MaruthiV/golem/web/preview.png

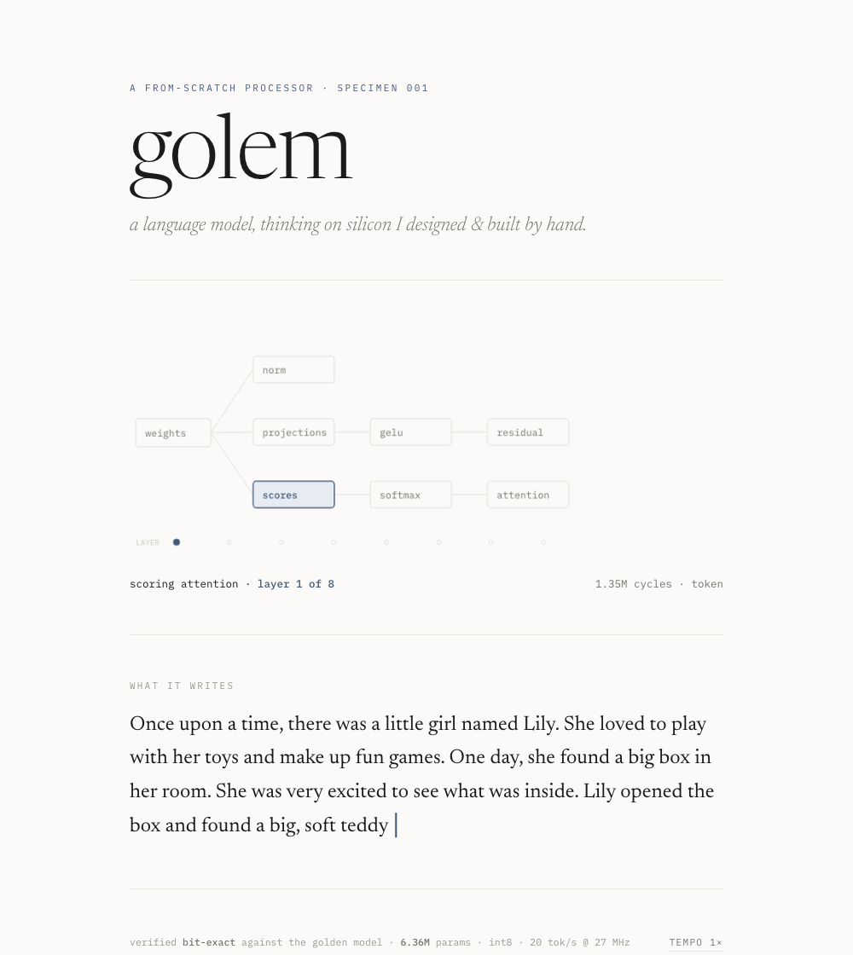
web/preview.png
