MaruthiV/golem/rtl/golem_board_top.sv

// golem_board_top — the actual FPGA top for the Tang Nano 20K. Boot flow:
//   LOAD: host streams the weight image over UART -> weight_loader writes it into SDRAM.
//   RUN:  control FSM drives golem; tokens stream out UART; host maps ids->text.
// NOTE: SDRAM modeled/wired 32-bit (matches the verified sim). Confirm the real chip's
// data width/timing from the datasheet during bring-up and adapt the data phase if 16-bit.
module golem_board_top #(
    // Internal clock. USE_PLL=0 runs straight off the 27 MHz oscillator; USE_PLL=1 brings up the
    // rPLL and everything (logic AND SDRAM) runs at CLK_MHZ. Raising this is the whole of T68:
    // golem is only 6% memory-stalled, so tok/s is now linear in the clock. Divider values must
    // satisfy CLK_MHZ = 27*(PLL_FBDIV+1)/(PLL_IDIV+1) with 400 <= CLK_MHZ*PLL_ODIV <= 1200.
    parameter int CLK_MHZ = 27,
    parameter int USE_PLL = 0,
    parameter int PLL_IDIV = 8, parameter int PLL_FBDIV = 21, parameter int PLL_ODIV = 8,
    parameter int PLL_PHASE = 10,          // SDRAM clock phase, 16ths of a period; swept on the board (T70/G7)
    parameter int DEMO_SLOW = 0,           // hold each pipeline stage on the LEDs long enough to film
    parameter int BAUD = 921600,           // 6.5 MB of weights is 9.4 min at 115200, 70 s here
    parameter int CLKS_PER_BIT = 0,        // 0 = derive from CLK_MHZ and BAUD
    parameter [11:0] START_TOK = 12'd0,
    parameter [7:0]  MAX_TOKENS = 8'd120,
    parameter [21:0] N_WORDS = 22'd1624264
) (
    input  logic        clk27,
    input  logic        rst_n,
    input  logic        uart_rx_pin,
    output logic        uart_tx_pin,
    output logic [5:0]  led,

    // The GW2AR-18's SDRAM is inside the package (SiP). nextpnr-himbaechel wires it up via
    // these EXACT dedicated port names — there are no IO_LOC constraints for SDRAM, which is
    // why nand2mario's working .cst has none. Naming them anything else (we had sdram_cs_n
    // etc.) makes nextpnr treat them as ordinary user I/O and fail with "Unconstrained IO".
    // addr is 11 bits here (2048 rows), not the controller's generic 13.
    output logic        O_sdram_clk,
    output logic        O_sdram_cke,
    output logic        O_sdram_cs_n, O_sdram_ras_n, O_sdram_cas_n, O_sdram_wen_n,
    output logic [3:0]  O_sdram_dqm,
    output logic [10:0] O_sdram_addr,
    output logic [1:0]  O_sdram_ba,
    inout  wire  [31:0] IO_sdram_dq
);
  localparam int CPB = (CLKS_PER_BIT > 0) ? CLKS_PER_BIT : (CLK_MHZ * 1000000) / BAUD;

  wire clk, sdram_clk;
  generate if (USE_PLL) begin : g_pll
    pll #(.IDIV(PLL_IDIV), .FBDIV(PLL_FBDIV), .ODIV(PLL_ODIV), .PHASE(PLL_PHASE))
      u_pll(.clkin(clk27), .clkout(clk), .clkoutp(sdram_clk), .lock());
  end else begin : g_nopll
    assign clk = clk27;
    assign sdram_clk = clk27;
  end endgenerate

  logic [1:0] rsync;
  always_ff @(posedge clk) rsync <= {rsync[0], ~rst_n};
  wire rst = rsync[1];

  // ---- UART rx -> weight loader ----
  // bytes are ignored until the SDRAM finishes its 200 us power-up: otherwise they become words
  // the controller cannot accept yet, the loader drops them while it waits, and the image
  // desyncs. Gating valid costs one LUT; gating reset would sit on a high-fanout net.
  logic sdram_ready;
  logic [7:0] rx_data; logic rx_valid_raw;
  wire rx_valid = rx_valid_raw & sdram_ready;
  uart_rx #(.CLKS_PER_BIT(CPB)) u_rx(.clk(clk), .rst(rst), .rx(uart_rx_pin),
                .data(rx_data), .valid(rx_valid_raw));
  logic ld_valid, ld_wr; logic [21:0] ld_addr; logic [31:0] ld_wdata; logic ld_ready, load_done;
  weight_loader #(.N_WORDS(N_WORDS)) u_ld(.clk(clk), .rst(rst),
                .rx_data(rx_data), .rx_valid(rx_valid),
                .cmd_valid(ld_valid), .cmd_wr(ld_wr), .cmd_addr(ld_addr), .cmd_wdata(ld_wdata),
                .cmd_ready(ld_ready), .done(load_done));
  wire loading = !load_done;

  // ---- golem + arbiter (RUN) ----
  wire fsm_rst = rst | loading;   // hold generation until weights are loaded
  logic g_start, g_busy, g_tvalid; logic [11:0] g_token, g_tout; logic [7:0] g_pos;
  logic [4:0] g_st;
  logic mrd_req, mrd_valid; logic [21:0] mrd_addr; logic [31:0] mrd_data;
  logic ws_req, ws_valid, ws_last; logic [21:0] ws_addr; logic [8:0] ws_len; logic [31:0] ws_data;
  logic kw, kws, krs, krq, krv; logic [16:0] kwa, kra; logic [31:0] kwd, krd;
  logic arb_valid, arb_wr; logic [21:0] arb_addr; logic [31:0] arb_wdata; logic arb_ready;
  logic [8:0] arb_len;
  logic c_valid, c_wr; logic [21:0] c_addr; logic [31:0] c_wdata, c_rdata;
  logic [8:0] c_len; logic c_ready, c_rvalid, c_rlast;

  golem u_golem(.clk(clk), .rst(fsm_rst), .start(g_start), .token(g_token), .pos(g_pos),
                .busy(g_busy), .mrd_addr(mrd_addr), .mrd_req(mrd_req), .mrd_valid(mrd_valid),
                .mrd_data(mrd_data), .kv_we(kw), .kv_wsel(kws), .kv_waddr(kwa), .kv_wdata(kwd),
                .kv_raddr(kra), .kv_rsel(krs), .kv_rreq(krq), .kv_rvalid(krv), .kv_rdata(krd),
                .tok_valid(g_tvalid), .tok_out(g_tout), .dbg_st(g_st));
    `include "golem_mem.svh"
  wstream #(.LB(7), .LIMIT_ADDR(23'(MEM_KV_BASE))) u_ws(.clk(clk), .rst(fsm_rst),
                .mrd_req(mrd_req), .mrd_addr(mrd_addr), .mrd_valid(mrd_valid), .mrd_data(mrd_data),
                .m_req(ws_req), .m_addr(ws_addr), .m_len(ws_len),
                .m_valid(ws_valid), .m_last(ws_last), .m_data(ws_data));
  mem_arbiter #(.KV_BASE(22'(MEM_KV_BASE))) u_arb(.clk(clk), .rst(fsm_rst),
                .mrd_req(ws_req), .mrd_addr(ws_addr), .mrd_len(ws_len),
                .mrd_valid(ws_valid), .mrd_last(ws_last), .mrd_data(ws_data),
                .kv_rreq(krq), .kv_raddr(kra), .kv_rsel(krs), .kv_rvalid(krv), .kv_rdata(krd),
                .kv_we(kw), .kv_waddr(kwa), .kv_wsel(kws), .kv_wdata(kwd),
                .o_valid(arb_valid), .o_wr(arb_wr), .o_addr(arb_addr), .o_len(arb_len),
                .o_wdata(arb_wdata),
                .i_ready(arb_ready), .i_rvalid(c_rvalid), .i_rlast(c_rlast), .i_rdata(c_rdata));

  // ---- SDRAM command port mux: loader owns it while loading, arbiter while running ----
  assign c_valid = loading ? ld_valid : arb_valid;
  assign c_wr    = loading ? ld_wr    : arb_wr;
  assign c_addr  = loading ? ld_addr  : arb_addr;
  assign c_len   = loading ? 9'd1     : arb_len;
  assign c_wdata = loading ? ld_wdata : arb_wdata;
  assign ld_ready  = loading ? c_ready : 1'b0;
  assign arb_ready = loading ? 1'b0    : c_ready;

  logic [31:0] dq_o, dq_i; logic dq_oe; logic [12:0] a_full;
  sdram_ctrl #(.CLK_MHZ(CLK_MHZ)) u_ctrl(.clk(clk), .rst(rst), .cmd_valid(c_valid), .cmd_wr(c_wr),
                .cmd_addr(c_addr), .cmd_len(c_len), .rd_last(c_rlast),
                .cmd_wdata(c_wdata), .cmd_ready(c_ready), .init_done(sdram_ready),
                .rd_valid(c_rvalid), .rd_data(c_rdata),
                .cs_n(O_sdram_cs_n), .ras_n(O_sdram_ras_n), .cas_n(O_sdram_cas_n),
                .we_n(O_sdram_wen_n), .cke(O_sdram_cke), .ba(O_sdram_ba), .a(a_full),
                .dq_o(dq_o), .dq_oe(dq_oe), .dq_i(dq_i));
  assign O_sdram_addr = a_full[10:0];       // 2048 rows; A10 is also the auto-precharge bit
  assign O_sdram_dqm  = 4'b0000;            // never mask: every access is a full 32-bit word
  assign O_sdram_clk  = sdram_clk;          // phase-shifted by the PLL when USE_PLL (T70 sweeps it)
  assign IO_sdram_dq = dq_oe ? dq_o : 32'bz;   // tristate the bidirectional data bus
  assign dq_i = IO_sdram_dq;

  // ---- UART tx ----
  logic u_send, u_busy; logic [7:0] u_data;
  uart_tx #(.CLKS_PER_BIT(CPB)) u_tx(.clk(clk), .rst(rst), .send(u_send), .data(u_data),
                .tx(uart_tx_pin), .busy(u_busy));

  // ---- control FSM (autonomous generation, started once weights are loaded) ----
  localparam C_INIT=0, C_START=1, C_STARTW=2, C_WAIT=3, C_HI=4, C_HIA=5, C_HID=6,
             C_LO=7, C_LOA=8, C_LOD=9, C_NEXT=10, C_DONE=11;
  logic [3:0] cst; logic [11:0] cur; logic [7:0] pos; logic story_done;
  always_ff @(posedge clk) begin
    g_start <= 1'b0; u_send <= 1'b0;
    if (fsm_rst) begin cst <= C_INIT; story_done <= 1'b0; end
    else case (cst)
      C_INIT:   begin cur <= START_TOK; pos <= 8'd0; cst <= C_START; end
      C_START:  begin g_token <= cur; g_pos <= pos; g_start <= 1'b1; cst <= C_STARTW; end
      C_STARTW: cst <= C_WAIT;
      C_WAIT:   if (g_tvalid) begin cur <= g_tout; cst <= C_HI; end
      C_HI:     if (!u_busy) begin u_send <= 1'b1; u_data <= {4'd0, cur[11:8]}; cst <= C_HIA; end
      C_HIA:    if (u_busy) cst <= C_HID;
      C_HID:    if (!u_busy) cst <= C_LO;
      C_LO:     if (!u_busy) begin u_send <= 1'b1; u_data <= cur[7:0]; cst <= C_LOA; end
      C_LOA:    if (u_busy) cst <= C_LOD;
      C_LOD:    if (!u_busy) cst <= C_NEXT;
      C_NEXT:   begin pos <= pos + 8'd1;
                if (pos == MAX_TOKENS - 8'd1 || cur == START_TOK) cst <= C_DONE; else cst <= C_START; end
      C_DONE:   story_done <= 1'b1;
      default:  cst <= C_INIT;
    endcase
  end

  // LEDs follow the inference pipeline, one per stage, so the board shows what it is doing.
  // The phases fly past in microseconds, so DEMO_SLOW stretches each one to ~50 ms for filming.
  // It only holds the LED, never the datapath, so timing and results are untouched.
  localparam S_ETOK=3, S_EPOS=4, S_ECMB=5, S_LX=6, S_WT=13, S_LG=18;
  wire ph_emb = (g_st == S_ETOK) || (g_st == S_EPOS) || (g_st == S_ECMB);
  wire ph_nrm = (g_st == S_LX);
  wire ph_lay = (g_st == S_WT);
  wire ph_log = (g_st == S_LG);
  logic [5:0] stage_now, stage_held;
  logic [21:0] hold;
  assign stage_now = {story_done, ph_log, ph_lay, ph_nrm, ph_emb, loading};
  always_ff @(posedge clk) begin
    if (rst) begin stage_held <= 6'd0; hold <= 22'd0; end
    else if (hold != 22'd0) hold <= hold - 22'd1;
    else if (stage_now != stage_held) begin
      stage_held <= stage_now;
      hold <= DEMO_SLOW ? 22'(CLK_MHZ * 50000) : 22'd0;   // 50 ms per stage when filming
    end
  end
  assign led = DEMO_SLOW ? stage_held : stage_now;
endmodule
