MaruthiV/golem/(commit log)

2026-07-15 init: golem — tiny LLM + from-scratch accelerator
2026-07-22 kv cache doesn't fit on board's LUT - need to externalize kv cache
2026-07-23 rtl: autonomous top (fsm + uart)
2026-07-23 fpga: synthesizecd board top
2026-07-26 feat: board final top
2026-08-07 feat: cycle-attribution probe
2026-08-07 optimization-curve artifact + regression fixes
    [golem_fpga.sv, golem_top.sv, opt_curve.py]
2026-08-07 fixing regression bugs from burst work
    [sdram_chip.sv, sdram_chip_io.sv, wstream.sv]
2026-08-11 two silicon bugs + PLL
    [golem_board_top.sv, pll.sv, sim_mem.sv, upload_weights.py]
